martonmiklos/oshw-design/e-ink/EAGLE/e-ink-display-v020/e-ink-display-v020.brd

## EAGLE design e-ink/EAGLE/e-ink-display-v020/e-ink-display-v020.brd (2019-09-29)

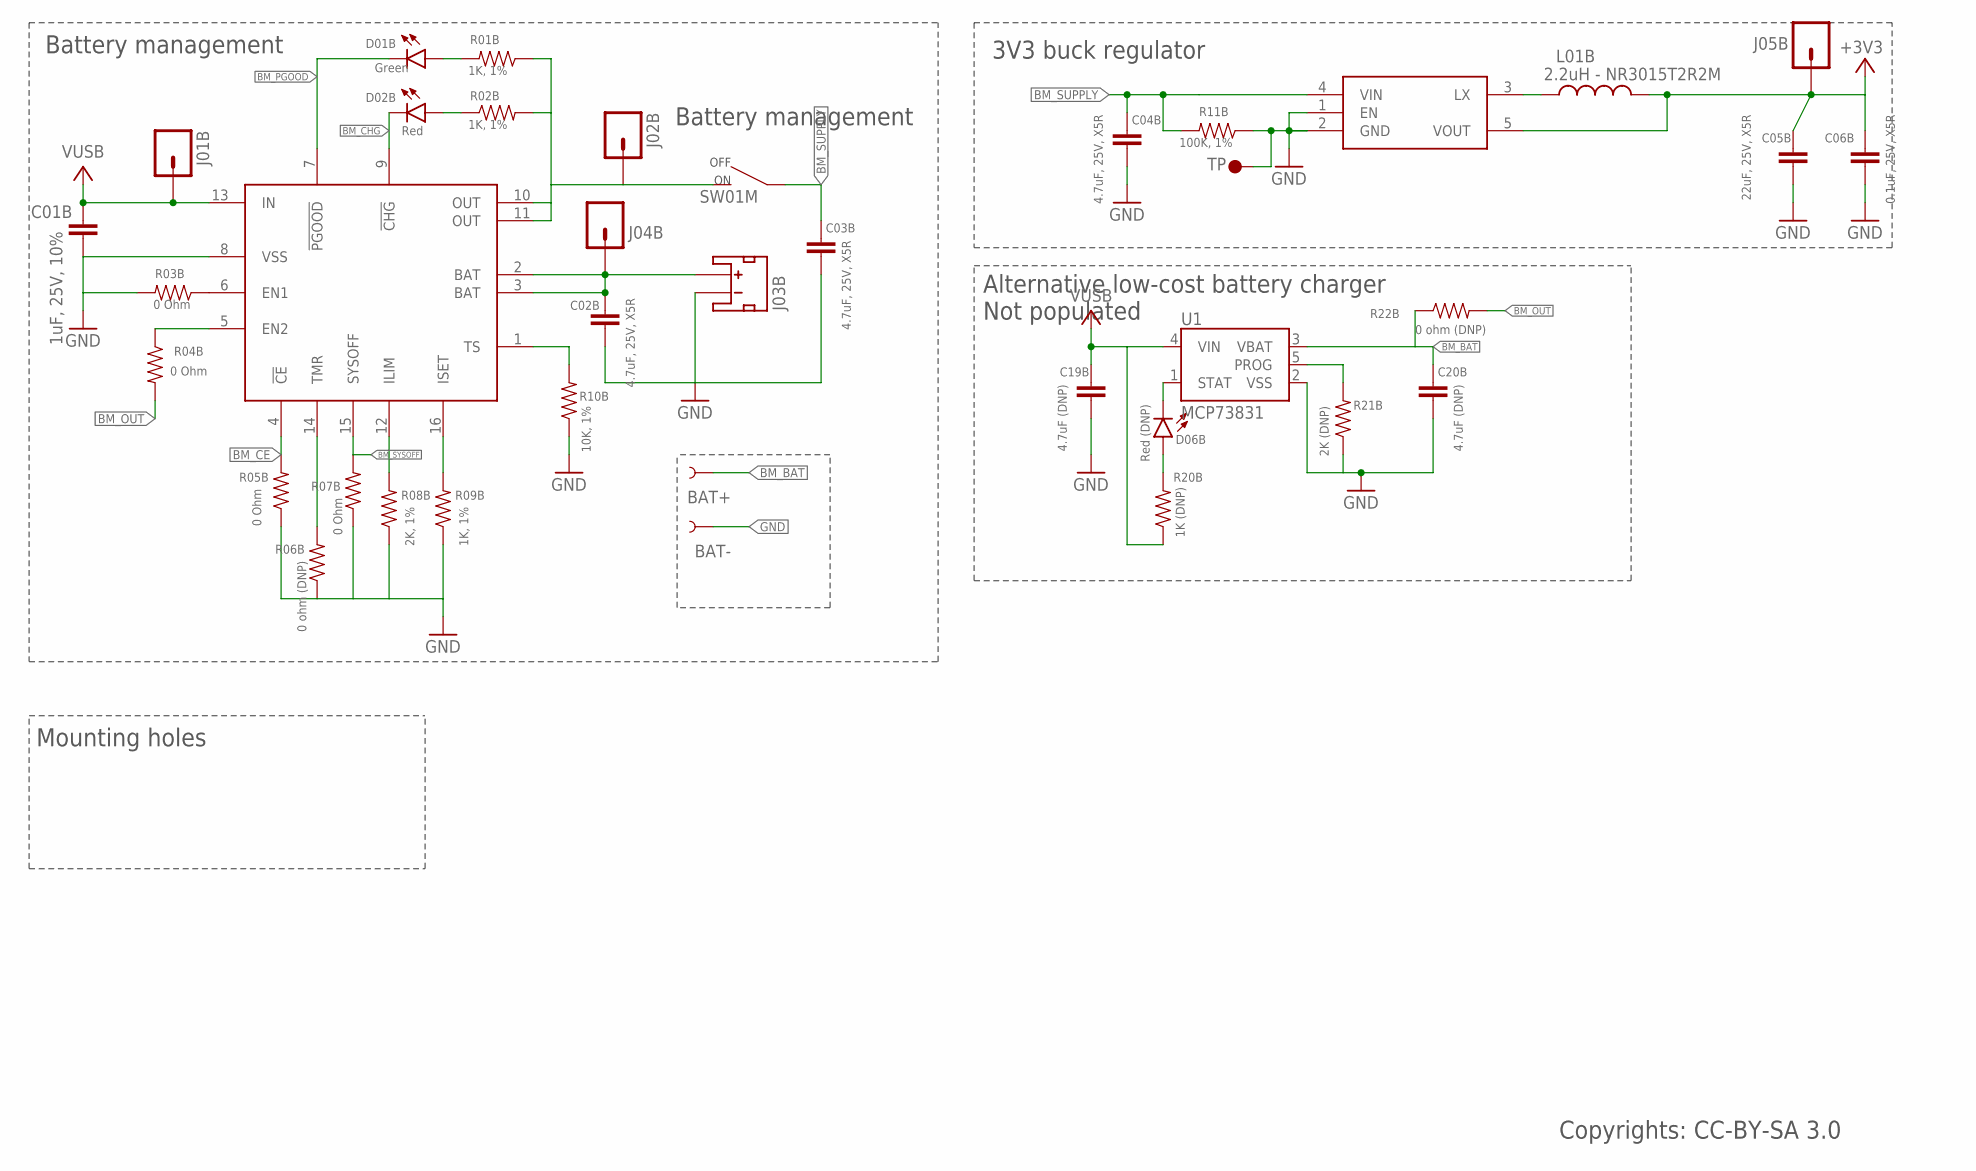
[picture p1: schematic e-ink-display-v020.sch, sheet 1, Power supply]

Parts:
BAT+: TEST-POINTSQ_THRU; TP-SQ_15TH
BAT-: TEST-POINTRD_THRU; TP-RD_15TH
C01B: 1uF, 25V, 10%; 0603-CAP
C02B, C03B, C04B: 4.7uF, 25V, X5R; 0603-CAP
C05B: 22uF, 25V, X5R; 0603-CAP
C06B: 0.1uF, 25V, X5R; 0603-CAP
C19B, C20B: 4.7uF (DNP); 0603-CAP
D01B: Green; LED-0603
D02B: Red; LED-0603
D06B: Red (DNP); LED-0603
J01B, J02B, J04B, J05B: M01PTH; 1X01
J03B: JST_2MM_MALE; JST-2-SMD
L01B: 2.2uH - NR3015T2R2M; INDUCTOR-NR3015
R01B, R02B, R09B: 1K, 1%; 0603-RES
R03B, R04B, R05B, R07B: 0 Ohm; 0603-RES
R06B: 0 ohm (DNP); 0603-RES
R08B: 2K, 1%; 0603-RES
R10B: 10K, 1%; 0603-RES
R11B: 100K, 1%; 0603-RES
R20B: 1K (DNP); 0603-RES
R21B: 2K (DNP); 0603-RES
R22B: 0 ohm (DNP); 1206
SW01M: SWITCHSIDE-SLIDE; SW-SPDT-TH
TP01B: TP1; TP35_BOT
U1: MCP73831; SOT23-5
U01B: BQ24075; PVQFN-16
U02B: R8008-33; SOT23-5

Connections:
+3V3: C05B.2, C06B.2, J05B.1, L01B.2, U02B.5 (VOUT); also elsewhere on the board
BM_BAT: BAT+.P$1, C02B.2, C20B.2, J03B.2 (+), J04B.1, R22B.1, U1.3 (VBAT), U01B.2 (BAT), U01B.3 (BAT)
BM_CE: R05B.2, U01B.4 (!CE)
BM_CHG: D02B.C, U01B.9 (!CHG); also elsewhere on the board
BM_OUT: J02B.1, R01B.1, R02B.2, R04B.2, R22B.2, SW01M.2, U01B.10 (OUT), U01B.11 (OUT)
BM_PGOOD: D01B.C, U01B.7 (!PGOOD); also elsewhere on the board
BM_SUPPLY: C03B.2, C04B.2, R11B.2, SW01M.1, U02B.4 (VIN); also elsewhere on the board
BM_SYSOFF: R07B.2, U01B.15 (SYSOFF)
GND: BAT-.P$1, C01B.1, C02B.1, C03B.1, C04B.1, C05B.1, C06B.1, C19B.1, C20B.1, J03B.1 (-), R03B.2, R05B.1, R06B.1, R07B.1, R08B.1, R09B.1, R10B.1, R11B.1, R21B.1, TP01B.P$1, U1.2 (VSS), U01B.8 (VSS), U02B.1 (EN), U02B.2 (GND); also elsewhere on the board
unnamed: R08B.2, U01B.12 (ILIM)
unnamed: R09B.2, U01B.16 (ISET)
unnamed: R04B.1, U01B.5 (EN2)
unnamed: R03B.1, U01B.6 (EN1)
unnamed: R06B.2, U01B.14 (TMR)
unnamed: R10B.2, U01B.1 (TS)
unnamed: D02B.A, R02B.1
unnamed: D01B.A, R01B.2
unnamed: R21B.2, U1.5 (PROG)
unnamed: L01B.1, U02B.3 (LX)
unnamed: D06B.C, U1.1 (STAT)
unnamed: D06B.A, R20B.2
VUSB: C01B.2, C19B.2, J01B.1, R20B.1, U1.4 (VIN), U01B.13 (IN); also elsewhere on the board

Notes on the sheet:
Battery management
3V3 buck regulator
Mounting holes
Alternative low-cost battery charger Not populated
Copyrights: CC-BY-SA 3.0

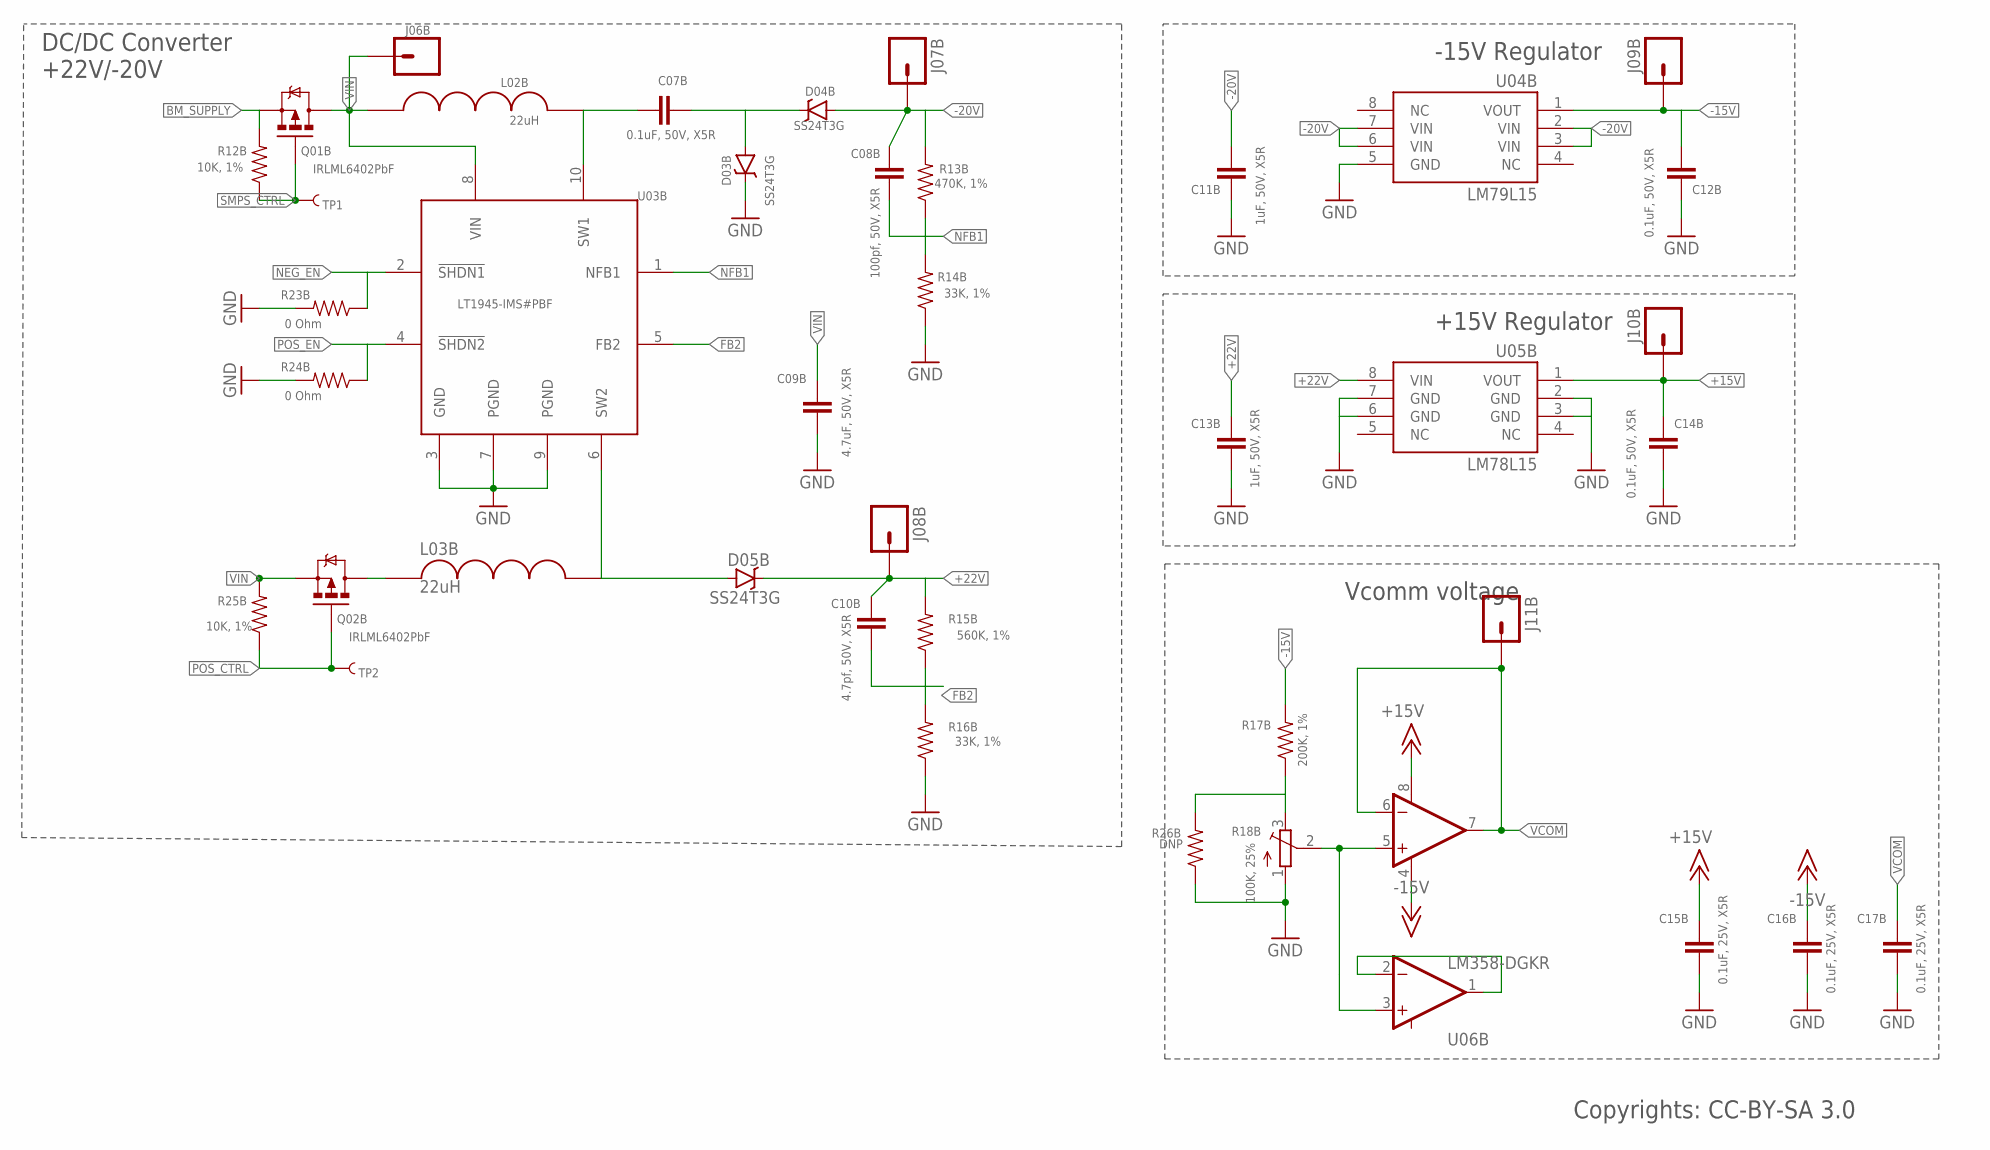
[picture p2: schematic e-ink-display-v020.sch, sheet 2, e-ink power supply]

Parts:
C07B, C12B, C14B: 0.1uF, 50V, X5R; 0603-CAP
C08B: 100pf, 50V, X5R; 0603-CAP
C09B: 4.7uF, 50V, X5R; 0603-CAP
C10B: 4.7pf, 50V, X5R; 0603-CAP
C11B, C13B: 1uF, 50V, X5R; 0603-CAP
C15B, C16B, C17B: 0.1uF, 25V, X5R; 0603-CAP
D03B, D04B, D05B: SS24T3G; SMA-DIODE
J06B, J07B, J08B, J09B, J10B, J11B: M01PTH; 1X01
L02B, L03B: 22uH; 4040(1515)
Q01B, Q02B: IRLML6402PbF; SOT23-3
R12B, R25B: 10K, 1%; 0603-RES
R13B: 470K, 1%; 0603-RES
R14B, R16B: 33K, 1%; 0603-RES
R15B: 560K, 1%; 0603-RES
R17B: 200K, 1%; 0603-RES
R18B: 100K, 25%; TC33X
R23B, R24B: 0 Ohm; 0603-RES
R26B: DNP; 0603-RES
TP1, TP2: TEST-POINTRD_THRU; TP-RD_15TH
U03B: LT1945-IMS#PBF; MSOP-10
U04B: LM79L15; SO08
U05B: LM78L15; SO08
U06B: LM358-DGKR; MSOP-8

Connections:
+15V: C14B.2, C15B.2, J10B.1, U05B.1 (VOUT), U06B.8 (V+); also elsewhere on the board
+22V: C10B.2, C13B.2, D05B.C, J08B.1, R15B.2, U05B.8 (VIN); also elsewhere on the board
-15V: C12B.2, C16B.2, J09B.1, R17B.2, U04B.1 (VOUT), U06B.4 (V-); also elsewhere on the board
-20V: C08B.2, C11B.2, D04B.A, J07B.1, R13B.2, U04B.2 (VIN), U04B.3 (VIN), U04B.6 (VIN), U04B.7 (VIN); also elsewhere on the board
BM_SUPPLY: Q01B.2 (S), R12B.2; also elsewhere on the board
FB2: C10B.1, R15B.1, R16B.2, U03B.5 (FB2)
GND: C09B.1, C11B.1, C12B.1, C13B.1, C14B.1, C15B.1, C16B.1, C17B.1, D03B.C, R14B.1, R16B.1, R18B.1 (A), R23B.2, R24B.2, R26B.1, U03B.3 (GND), U03B.7 (PGND), U03B.9 (PGND), U04B.5 (GND), U05B.2 (GND), U05B.3 (GND), U05B.6 (GND), U05B.7 (GND); also elsewhere on the board
unnamed: C07B.1, L02B.P$2, U03B.10 (SW1)
unnamed: C07B.2, D03B.A, D04B.C
unnamed: R18B.2 (S), U06B.3 (+IN1), U06B.5 (+IN2)
unnamed: D05B.A, L03B.P$2, U03B.6 (SW2)
unnamed: U06B.1 (OUT1), U06B.2 (-IN1)
unnamed: L03B.P$1, Q02B.3 (D)
unnamed: R17B.1, R18B.3 (E), R26B.2
NEG_EN: R23B.1, U03B.2 (!SHDN1); also elsewhere on the board
NFB1: C08B.1, R13B.1, R14B.2, U03B.1 (NFB1)
POS_CTRL: Q02B.1 (G), R25B.1, TP2.P$1; also elsewhere on the board
POS_EN: R24B.1, U03B.4 (!SHDN2); also elsewhere on the board
SMPS_CTRL: Q01B.1 (G), R12B.1, TP1.P$1; also elsewhere on the board
VCOM: C17B.2, J11B.1, U06B.6 (-IN2), U06B.7 (OUT2); also elsewhere on the board
VIN: C09B.2, J06B.1, L02B.P$1, Q01B.3 (D), Q02B.2 (S), R25B.2, U03B.8 (VIN)

Notes on the sheet:
-15V Regulator
+15V Regulator
Vcomm voltage
DC/DC Converter +22V/-20V
Copyrights: CC-BY-SA 3.0

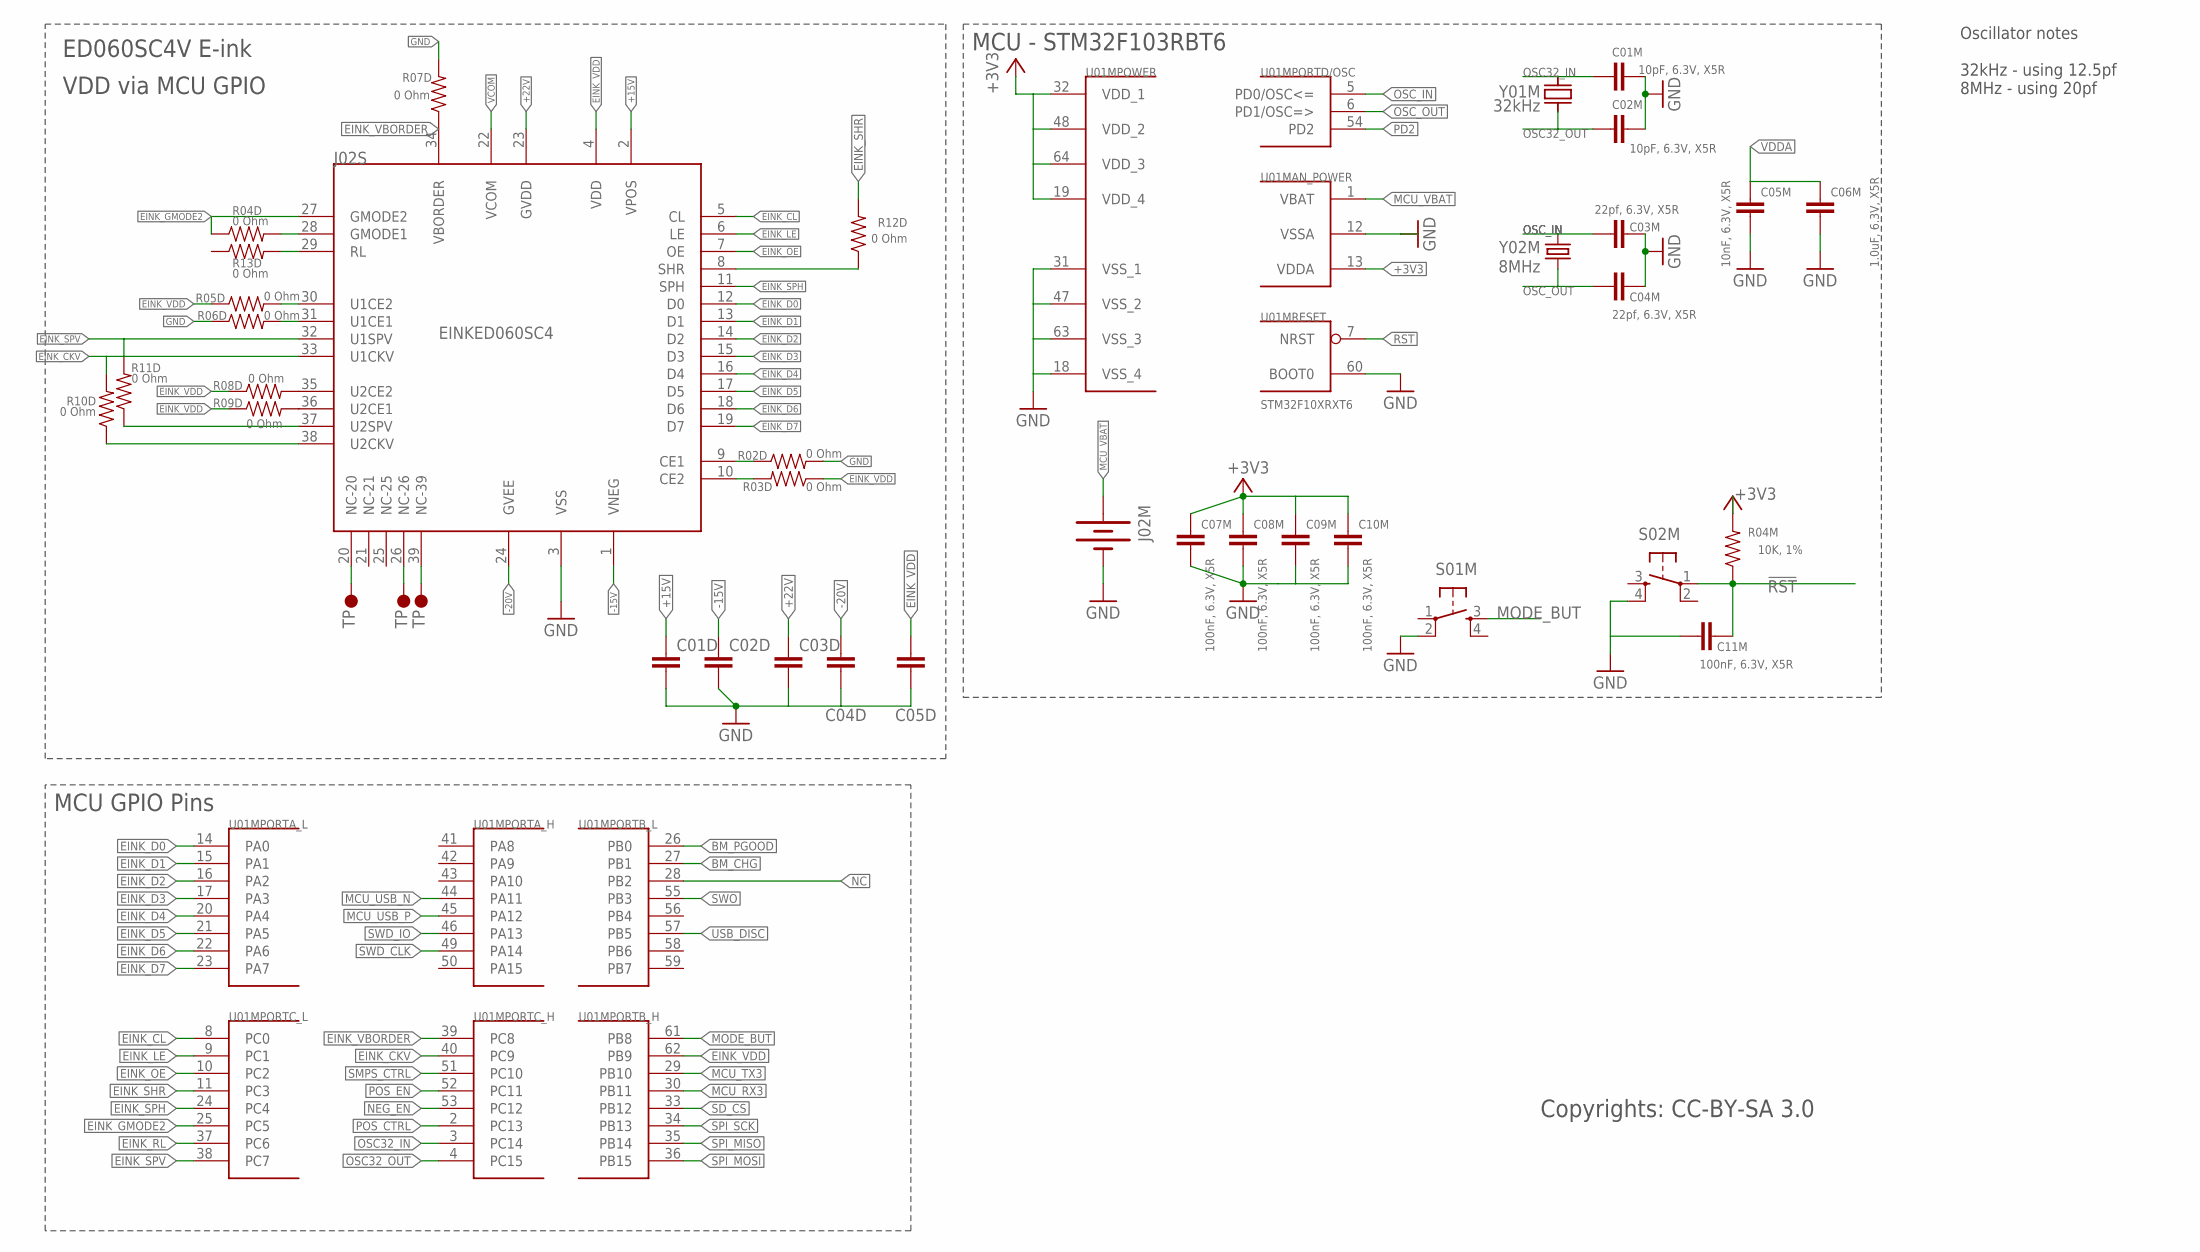
[picture p3: schematic e-ink-display-v020.sch, sheet 3, e-ink display & MCU]

Parts:
C01D, C02D, C03D, C04D, C05D: 100nF; 0603-CAP
C01M, C02M: 10pF, 6.3V, X5R; 0603-CAP
C03M, C04M: 22pf, 6.3V, X5R; 0603-CAP
C05M: 10nF, 6.3V, X5R; 0603-CAP
C06M: 1.0uF, 6.3V, X5R; 0603-CAP
C07M, C08M, C09M, C10M, C11M: 100nF, 6.3V, X5R; 0603-CAP
J02M: BATTERY20PTH; BATTCOM_20MM_PTH
J02S: EINKED060SC4; FPC-0.3-39
R02D, R03D, R04D, R05D, R06D, R07D, R08D, R09D, R10D, R11D, R12D, R13D: 0 Ohm; 0603-RES
R04M: 10K, 1%; 0603-RES
S01M, S02M: TAC_SWITCHSMD; TACTILE_SWITCH_SMD
U01M: STM32F10XRXT6; TQFP64
U$1, U$8, U$9: TP1; TP35_BOT
Y01M: 32kHz; FC135
Y02M: 8MHz; CRYSTAL-SMD-5X3

Connections:
!RST: C11M.1, R04M.1, S02M.1, U01M.7 (NRST); also elsewhere on the board
+3V3: C07M.1, C08M.1, C09M.1, C10M.1, R04M.2, U01M.13 (VDDA), U01M.19 (VDD_4), U01M.32 (VDD_1), U01M.48 (VDD_2), U01M.64 (VDD_3); also elsewhere on the board
+15V: C01D.1, J02S.2 (VPOS); also elsewhere on the board
+22V: C03D.1, J02S.23 (GVDD); also elsewhere on the board
-15V: C02D.1, J02S.1 (VNEG); also elsewhere on the board
-20V: C04D.1, J02S.24 (GVEE); also elsewhere on the board
BM_CHG: U01M.27 (PB1); also elsewhere on the board
BM_PGOOD: U01M.26 (PB0); also elsewhere on the board
CE2: J02S.10 (CE2), R03D.2
EINK_CKV: J02S.33 (U1CKV), R10D.2, U01M.40 (PC9); also elsewhere on the board
EINK_CL: J02S.5 (CL), U01M.8 (PC0); also elsewhere on the board
EINK_D0: J02S.12 (D0), U01M.14 (PA0); also elsewhere on the board
EINK_D1: J02S.13 (D1), U01M.15 (PA1); also elsewhere on the board
EINK_D2: J02S.14 (D2), U01M.16 (PA2); also elsewhere on the board
EINK_D3: J02S.15 (D3), U01M.17 (PA3); also elsewhere on the board
EINK_D4: J02S.16 (D4), U01M.20 (PA4); also elsewhere on the board
EINK_D5: J02S.17 (D5), U01M.21 (PA5); also elsewhere on the board
EINK_D6: J02S.18 (D6), U01M.22 (PA6); also elsewhere on the board
EINK_D7: J02S.19 (D7), U01M.23 (PA7); also elsewhere on the board
EINK_GMODE2: J02S.27 (GMODE2), R04D.1, U01M.25 (PC5); also elsewhere on the board
EINK_LE: J02S.6 (LE), U01M.9 (PC1); also elsewhere on the board
EINK_OE: J02S.7 (OE), U01M.10 (PC2); also elsewhere on the board
EINK_RL: U01M.37 (PC6); also elsewhere on the board
EINK_SHR: R12D.2, U01M.11 (PC3); also elsewhere on the board
EINK_SPH: J02S.11 (SPH), U01M.24 (PC4); also elsewhere on the board
EINK_SPV: J02S.32 (U1SPV), R11D.2, U01M.38 (PC7); also elsewhere on the board
EINK_VBORDER: J02S.34 (VBORDER), R07D.1, U01M.39 (PC8); also elsewhere on the board
EINK_VDD: C05D.1, J02S.4 (VDD), R03D.1, R05D.1, R08D.1, R09D.1, U01M.62 (PB9); also elsewhere on the board
GND: C01D.2, C01M.2, C02D.2, C02M.2, C03D.2, C03M.2, C04D.2, C04M.2, C05D.2, C05M.2, C06M.2, C07M.2, C08M.2, C09M.2, C10M.2, C11M.2, J02M.2 (-), J02S.3 (VSS), R02D.2, R06D.1, R07D.2, S01M.2, S02M.4, U01M.12 (VSSA), U01M.18 (VSS_4), U01M.31 (VSS_1), U01M.47 (VSS_2), U01M.60 (BOOT0), U01M.63 (VSS_3); also elsewhere on the board
MCU_RX3: U01M.30 (PB11); also elsewhere on the board
MCU_TX3: U01M.29 (PB10); also elsewhere on the board
MCU_USB_N: U01M.44 (PA11); also elsewhere on the board
MCU_USB_P: U01M.45 (PA12); also elsewhere on the board
MCU_VBAT: J02M.1 (+), U01M.1 (VBAT)
MODE_BUT: S01M.3, U01M.61 (PB8)
unnamed: J02S.28 (GMODE1), R04D.2
unnamed: J02S.31 (U1CE1), R06D.2
unnamed: J02S.29 (RL), R13D.2
unnamed: J02S.35 (U2CE2), R08D.2
unnamed: J02S.36 (U2CE1), R09D.2
unnamed: J02S.9 (CE1), R02D.1
unnamed: J02S.20 (NC-20), U$1.P$1
unnamed: J02S.26 (NC-26), U$8.P$1
unnamed: J02S.8 (SHR), R12D.1
unnamed: J02S.39 (NC-39), U$9.P$1
NC: U01M.28 (PB2)
NEG_EN: U01M.53 (PC12); also elsewhere on the board
OSC32_IN: C01M.1, U01M.3 (PC14), Y01M.X2 (2)
OSC32_OUT: C02M.1, U01M.4 (PC15), Y01M.X1 (1)
OSC_IN: C03M.1, U01M.5 (PD0/OSC<=), Y02M.3 (2)
OSC_OUT: C04M.1, U01M.6 (PD1/OSC=>), Y02M.1
PD2: U01M.54 (PD2)
POS_CTRL: U01M.2 (PC13); also elsewhere on the board
POS_EN: U01M.52 (PC11); also elsewhere on the board
SD_CS: U01M.33 (PB12); also elsewhere on the board
SMPS_CTRL: U01M.51 (PC10); also elsewhere on the board
SPI_MISO: U01M.35 (PB14); also elsewhere on the board
SPI_MOSI: U01M.36 (PB15); also elsewhere on the board
SPI_SCK: U01M.34 (PB13); also elsewhere on the board
SWD_CLK: U01M.49 (PA14); also elsewhere on the board
SWD_IO: U01M.46 (PA13); also elsewhere on the board
SWO: U01M.55 (PB3); also elsewhere on the board
U1CE2: J02S.30 (U1CE2), R05D.2
U2CKV: J02S.38 (U2CKV), R10D.1
U2SPV: J02S.37 (U2SPV), R11D.1
USB_DISC: U01M.57 (PB5); also elsewhere on the board
VCOM: J02S.22 (VCOM); also elsewhere on the board
VDDA: C05M.1, C06M.1

Notes on the sheet:
ED060SC4V E-ink VDD via MCU GPIO
MCU - STM32F103RBT6
Copyrights: CC-BY-SA 3.0
MCU GPIO Pins
Oscillator notes 32kHz - using 12.5pf 8MHz - using 20pf

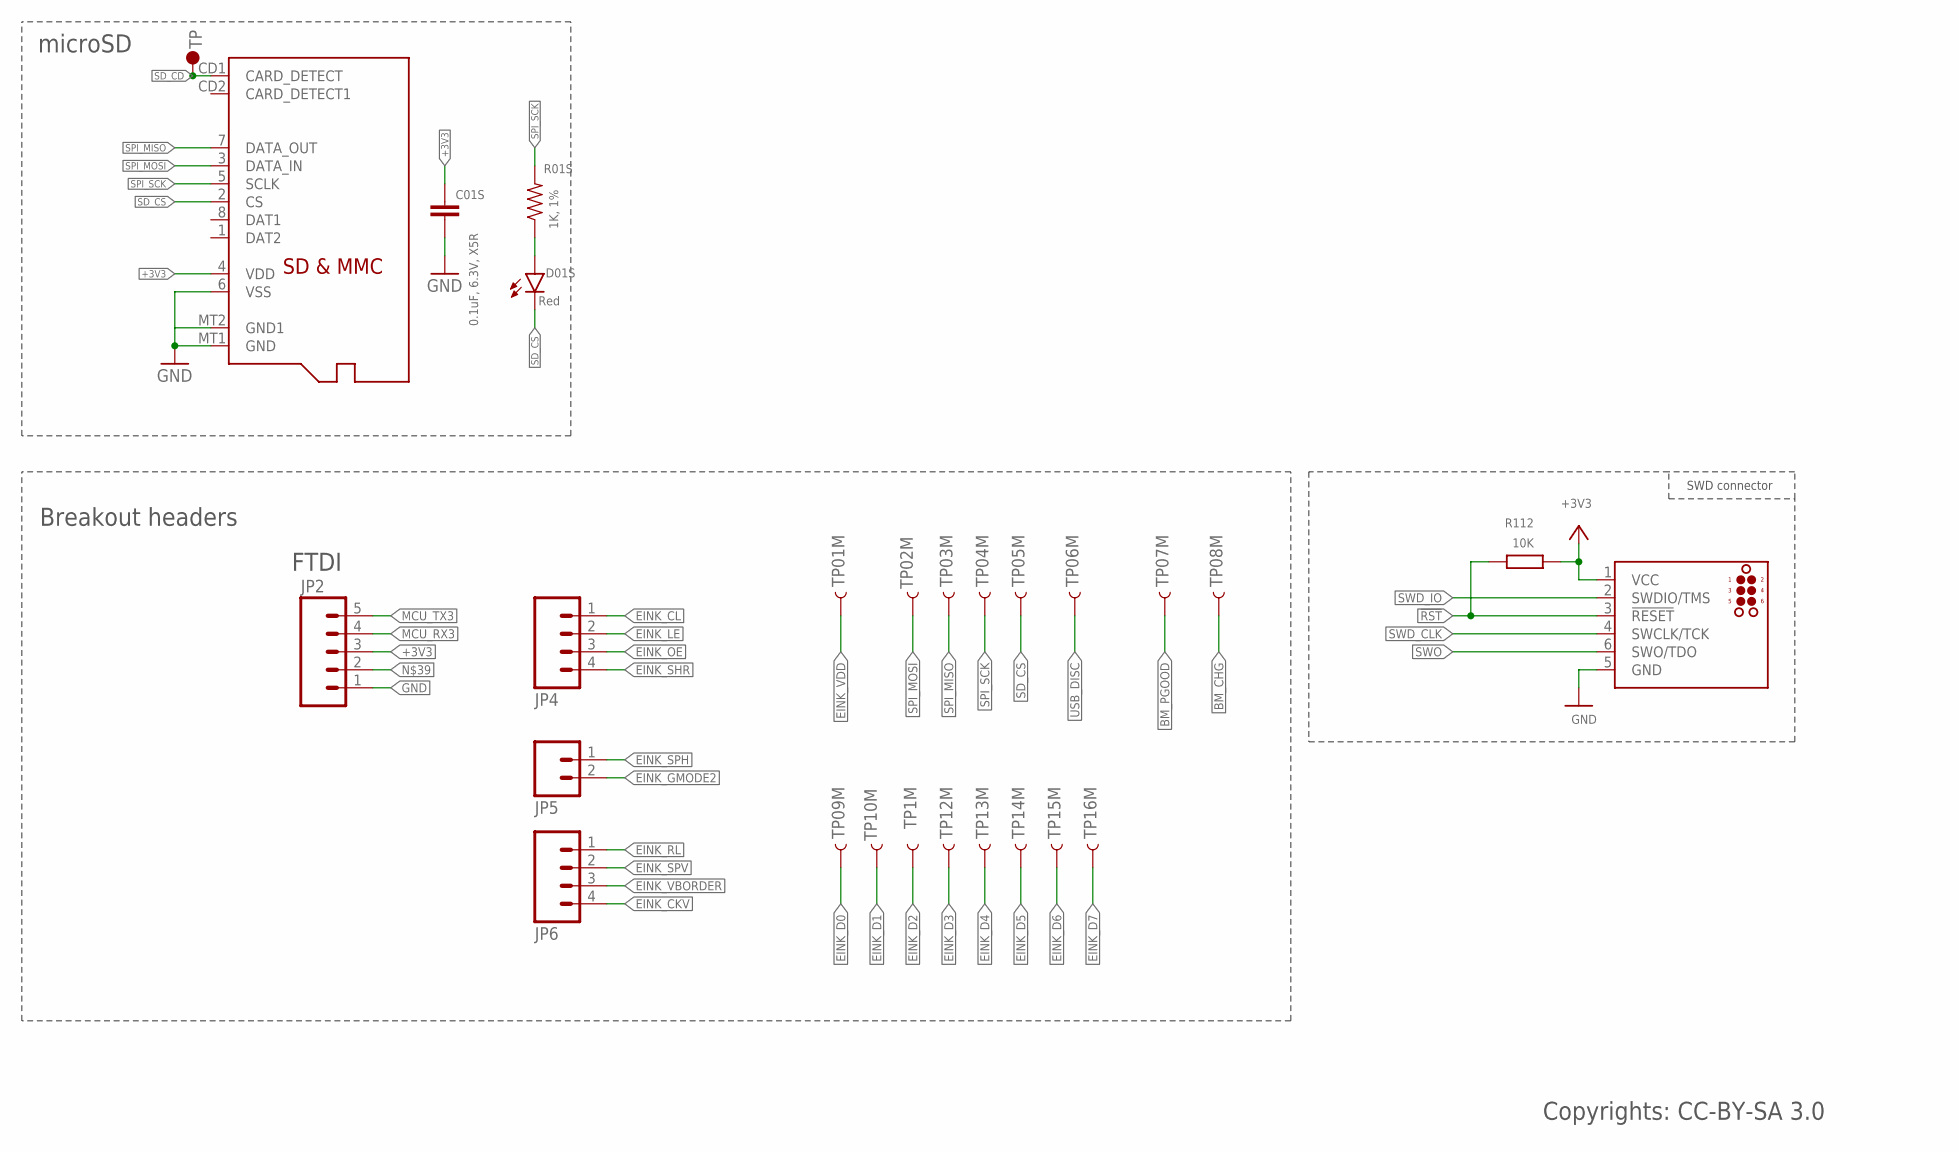
[picture p4: schematic e-ink-display-v020.sch, sheet 4, Peripherals]

Parts:
C01S: 0.1uF, 6.3V, X5R; 0603-CAP
D01S: Red; LED-0603
J1: TC2030_SWD-MCP-NL; TC2030-MCP-NL
J01S: MICROSD
JP2: M05PTH; 1X05
JP4, JP6: M04PTH; 1X04
JP5: M02PTH; 1X02
R01S: 1K, 1%; 0603-RES
R112: 10K; R0603
TP1M, TP01M, TP02M, TP04M, TP05M, TP06M, TP07M, TP08M, TP09M, TP10M, TP12M, TP13M, TP14M, TP15M, TP16M: TEST-POINTRD_THRU; TP-RD_15TH
TP03M: TEST-POINTTP_15TH_THRU; TP_15TH
U$5: TP3; TP60_BOT

Connections:
!RST: J1.3 (!RESET), R112.2; also elsewhere on the board
+3V3: C01S.1, J1.1 (VCC), J01S.4 (VDD), JP2.3, R112.1; also elsewhere on the board
BM_CHG: TP08M.P$1; also elsewhere on the board
BM_PGOOD: TP07M.P$1; also elsewhere on the board
EINK_CKV: JP6.4; also elsewhere on the board
EINK_CL: JP4.1; also elsewhere on the board
EINK_D0: TP09M.P$1; also elsewhere on the board
EINK_D1: TP10M.P$1; also elsewhere on the board
EINK_D2: TP1M.P$1; also elsewhere on the board
EINK_D3: TP12M.P$1; also elsewhere on the board
EINK_D4: TP13M.P$1; also elsewhere on the board
EINK_D5: TP14M.P$1; also elsewhere on the board
EINK_D6: TP15M.P$1; also elsewhere on the board
EINK_D7: TP16M.P$1; also elsewhere on the board
EINK_GMODE2: JP5.2; also elsewhere on the board
EINK_LE: JP4.2; also elsewhere on the board
EINK_OE: JP4.3; also elsewhere on the board
EINK_RL: JP6.1; also elsewhere on the board
EINK_SHR: JP4.4; also elsewhere on the board
EINK_SPH: JP5.1; also elsewhere on the board
EINK_SPV: JP6.2; also elsewhere on the board
EINK_VBORDER: JP6.3; also elsewhere on the board
EINK_VDD: TP01M.P$1; also elsewhere on the board
GND: C01S.2, J1.5 (GND), J01S.6 (VSS), J01S.MT1 (GND), J01S.MT2 (GND1), JP2.1; also elsewhere on the board
MCU_RX3: JP2.4; also elsewhere on the board
MCU_TX3: JP2.5; also elsewhere on the board
R01S: D01S.A, R01S.1
SD_CD: J01S.CD1 (CARD_DETECT), U$5.P$1
SD_CS: D01S.C, J01S.2 (CS), TP05M.P$1; also elsewhere on the board
SPI_MISO: J01S.7 (DATA_OUT), TP03M.P$1; also elsewhere on the board
SPI_MOSI: J01S.3 (DATA_IN), TP02M.P$1; also elsewhere on the board
SPI_SCK: J01S.5 (SCLK), R01S.2, TP04M.P$1; also elsewhere on the board
SWD_CLK: J1.4 (SWCLK/TCK); also elsewhere on the board
SWD_IO: J1.2 (SWDIO/TMS); also elsewhere on the board
SWO: J1.6 (SWO/TDO); also elsewhere on the board
USB_DISC: TP06M.P$1; also elsewhere on the board

Notes on the sheet:
microSD
Copyrights: CC-BY-SA 3.0
FTDI
Breakout headers
SWD connector

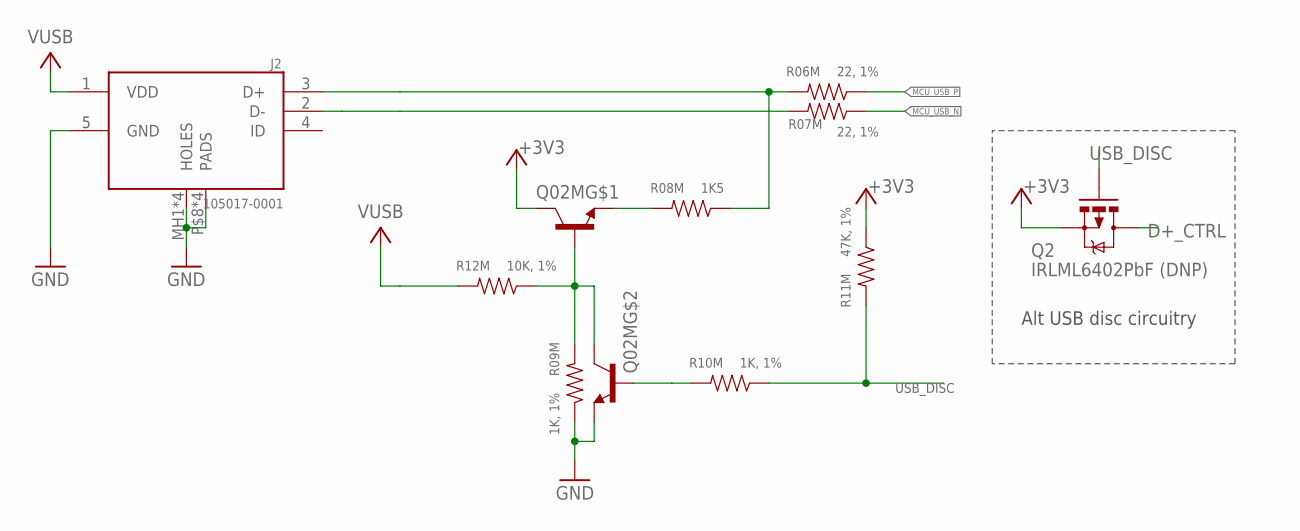
[picture p5: schematic e-ink-display-v020.sch, sheet 5]

Parts:
J2: 105017-0001; MOLEX_105017-0001
Q2: IRLML6402PbF (DNP); SOT23-3
Q02M: MMDT3904; SOT363
R06M, R07M: 22, 1%; 0603-RES
R08M: 1K5; 0603-RES
R09M, R10M: 1K, 1%; 0603-RES
R11M: 47K, 1%; 0603-RES
R12M: 10K, 1%; 0603-RES

Connections:
+3V3: Q2.2 (S), Q02M.6 (C), R11M.1; also elsewhere on the board
D+_CTRL: Q2.3 (D), Q02M.1 (E), R08M.2
GND: J2.5 (GND), J2.MH1 (HOLES), J2.MH2 (HOLES), J2.MH3 (HOLES), J2.MH4 (HOLES), J2.P$8 (PADS), J2.P$9 (PADS), J2.P$10 (PADS), J2.P$11 (PADS), Q02M.4 (E), R09M.1; also elsewhere on the board
MCU_USB_N: R07M.1; also elsewhere on the board
MCU_USB_P: R06M.1; also elsewhere on the board
MCU_USB_R_N: J2.2 (D-), R07M.2
MCU_USB__R_P: J2.3 (D+), R06M.2, R08M.1
unnamed: Q02M.2 (B), Q02M.3 (C), R09M.2, R12M.1
unnamed: Q02M.5 (B), R10M.2
USB_DISC: Q2.1 (G), R10M.1, R11M.2; also elsewhere on the board
VUSB: J2.1 (VDD), R12M.2; also elsewhere on the board

Notes on the sheet:
Alt USB disc circuitry

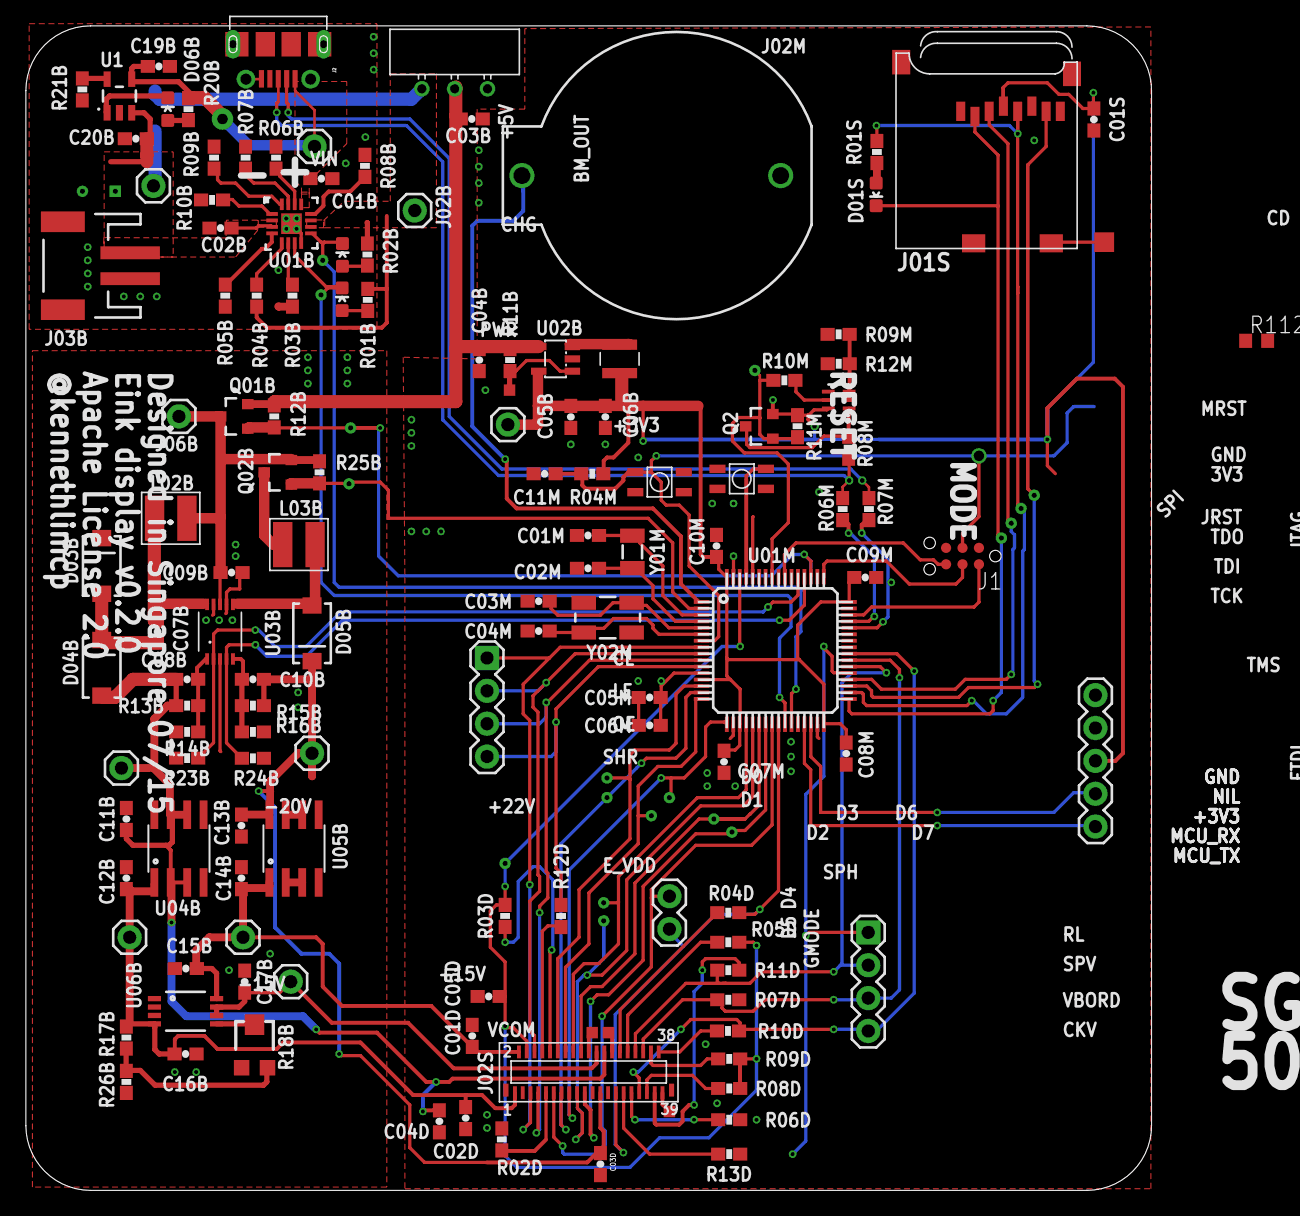
[picture p6: board e-ink-display-v020.brd from above]

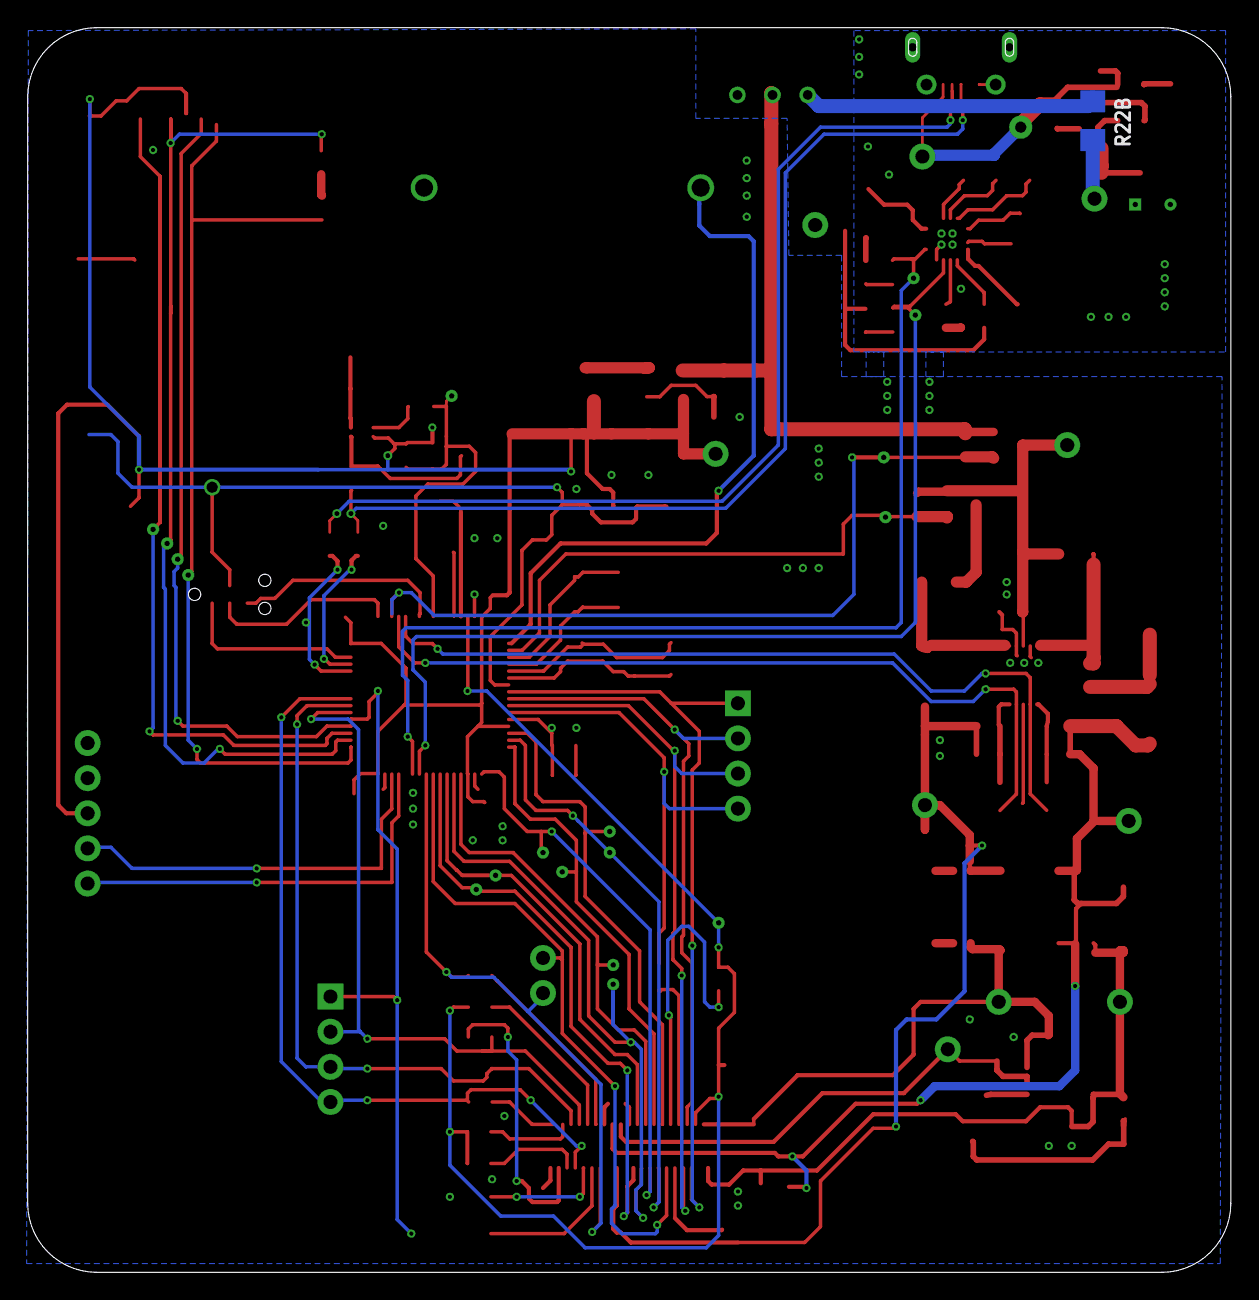
[picture p7: board e-ink-display-v020.brd from below]

Board: 2 copper layers, 87.0 x 90.0 mm, 155 parts (6 on the bottom side), 101 nets.
