martonmiklos/oshw-design/(notices)

Notices in the files:
e-ink/EAGLE/e-ink-display-v020/e-ink-display-v020.brd:
Apache License 2.0
parts and their libraries:
SparkFun-Capacitors: Licensing: Creative Commons ShareAlike 4.0 International - https://creativecommons.org/licenses/by-sa/4.0
tag-connect: ©2009 ROFA.cz - modified and updated by Robert Darlington ‹rdarlington@gmail.com›
